Rafdigo/portable-weather-data-logger/dr2/README.md

# Design Review 2 (DR2) - Fabrication Package

Materials for the second design review (week 14): everything needed to manufacture both boards.

Suggested contents of this folder:

- Gerber and drill files, pick-and-place data
- Final BOM and assembly drawings
- Layout screenshots and design rule check (DRC) report
- Review feedback and the resulting changes
