Rafdigo/portable-weather-data-logger/dr1/README.md

# Design Review 1 (DR1) - Schematics

Materials for the first design review (week 8): complete schematics of both boards.

Suggested contents of this folder:

- Schematic PDFs of Board A and Board B
- Block diagram and power budget
- Component selection notes (sensors, MCU, radio, power chain)
- Review feedback and the resulting changes
