Rafdigo/portable-weather-data-logger/docs/README.md

# Documentation

Design notes, schematic PDFs, datasheet references and design review documents.
