Rafdigo/portable-weather-data-logger/B_board/README.md

# Board B - Sensor Node

Altium project for Board B: STM32G474RET6, environmental sensors, adaptive aspiration fan, SX1262 868 MHz radio.

Put the Altium project files (.PrjPcb, .SchDoc, .PcbDoc, libraries) in this folder.
