Rafdigo/portable-weather-data-logger/A_board/README.md

# Board A - Control Node

Altium project for Board A: STM32F105R8T6TR, SD card storage, USB export, touchscreen LCD, SX1262 868 MHz radio.

Put the Altium project files (.PrjPcb, .SchDoc, .PcbDoc, libraries) in this folder.
