Rafdigo/portable-weather-data-logger/bom/README.md

# Bill of Materials

BOM exports (CSV/XLSX) and supplier notes (LCSC / JLCPCB assembly).
