Rafdigo/portable-weather-data-logger/docs/B board PDF.pdf

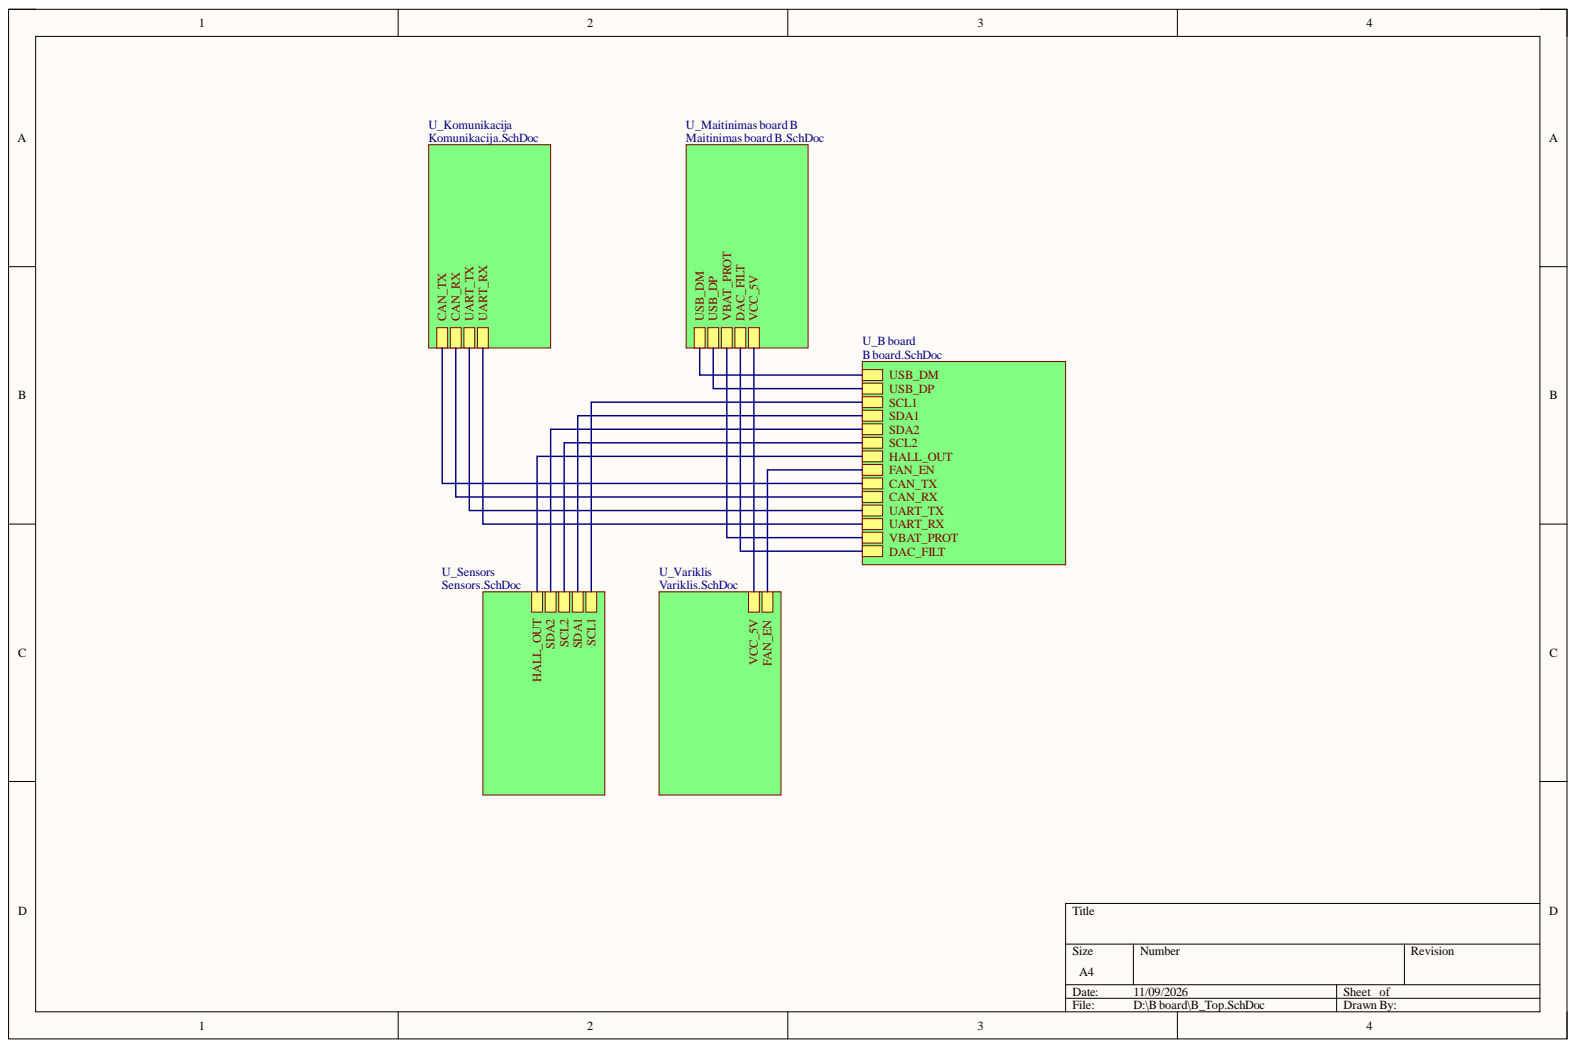
[picture p1: page 1]

Size A4 | Number | Revision

Date: 11/09/2026 | Sheet of
File: D:\Bboard\B_Top.SchDoc | Drawn By:

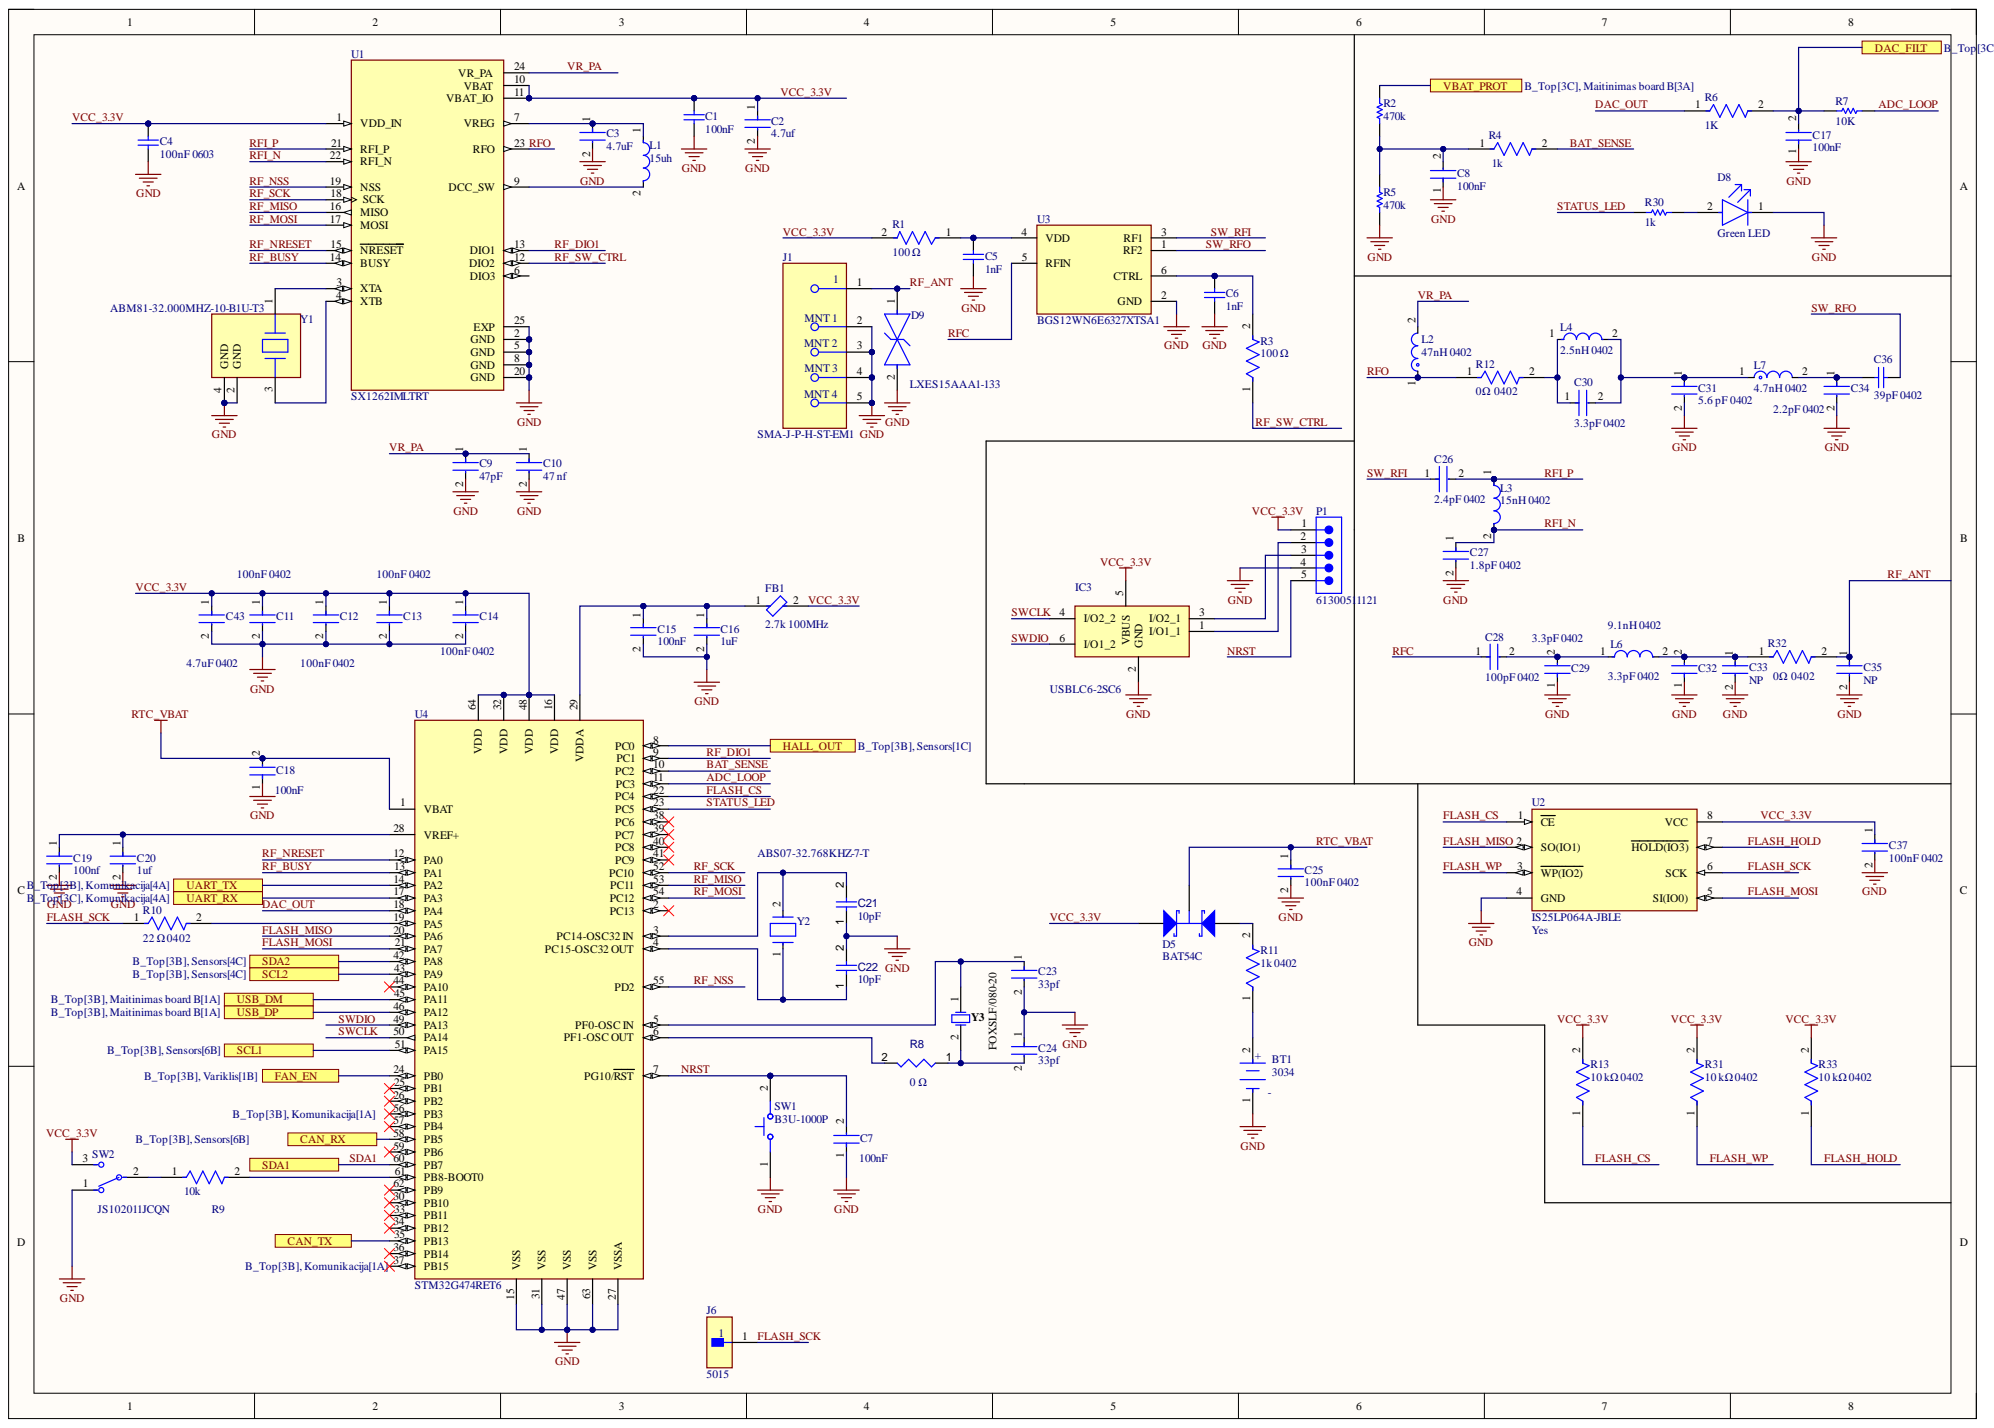
[picture p2: page 2]

CAN_TX | PB14 36

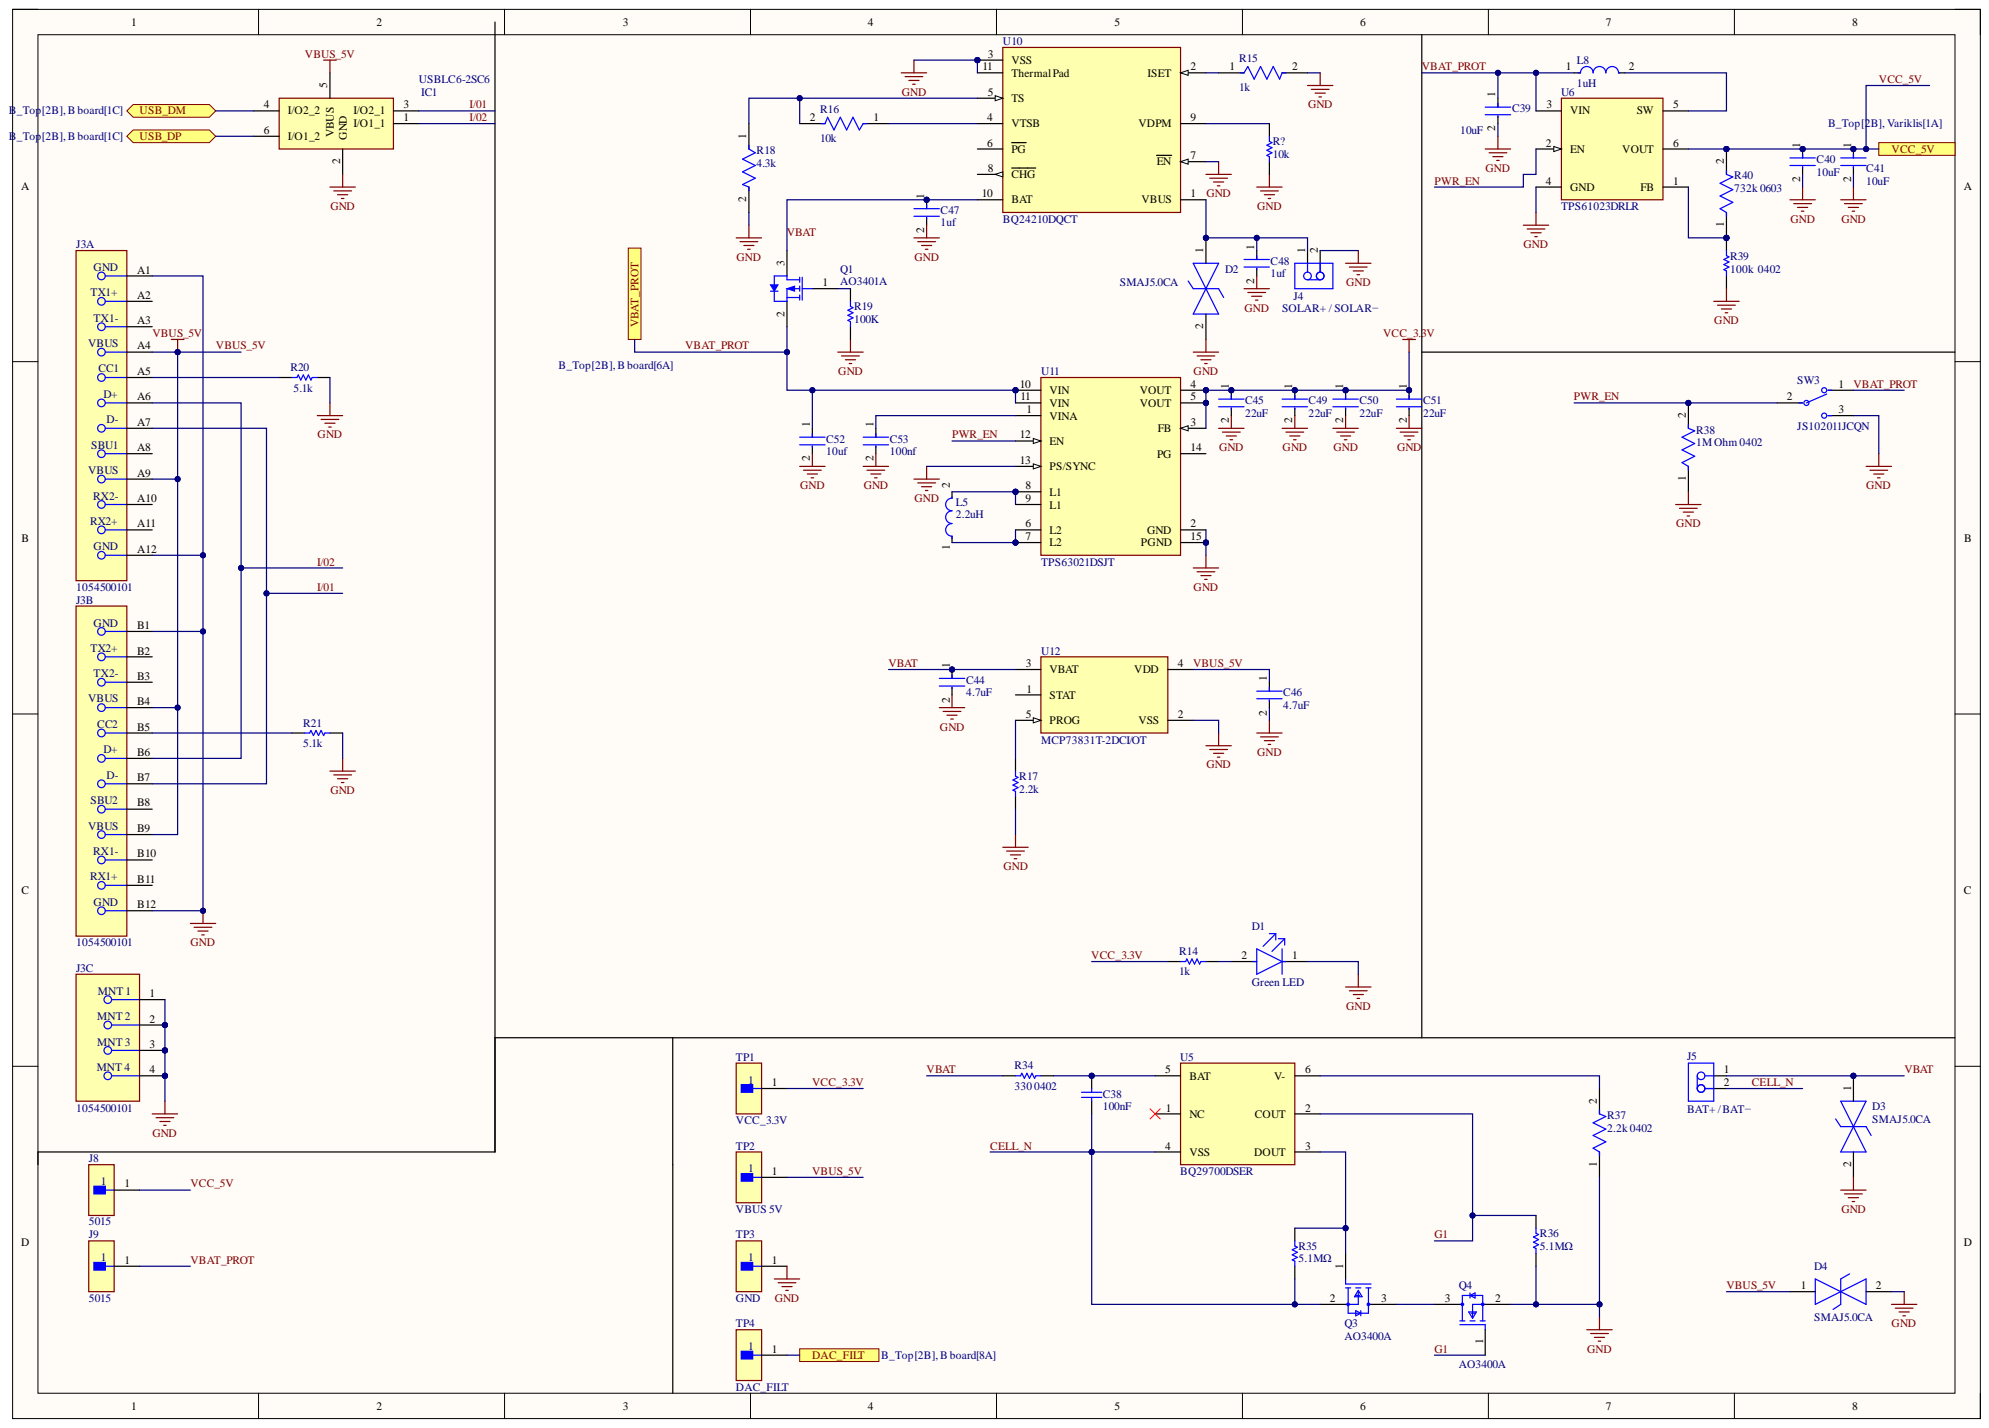
[picture p3: page 3]

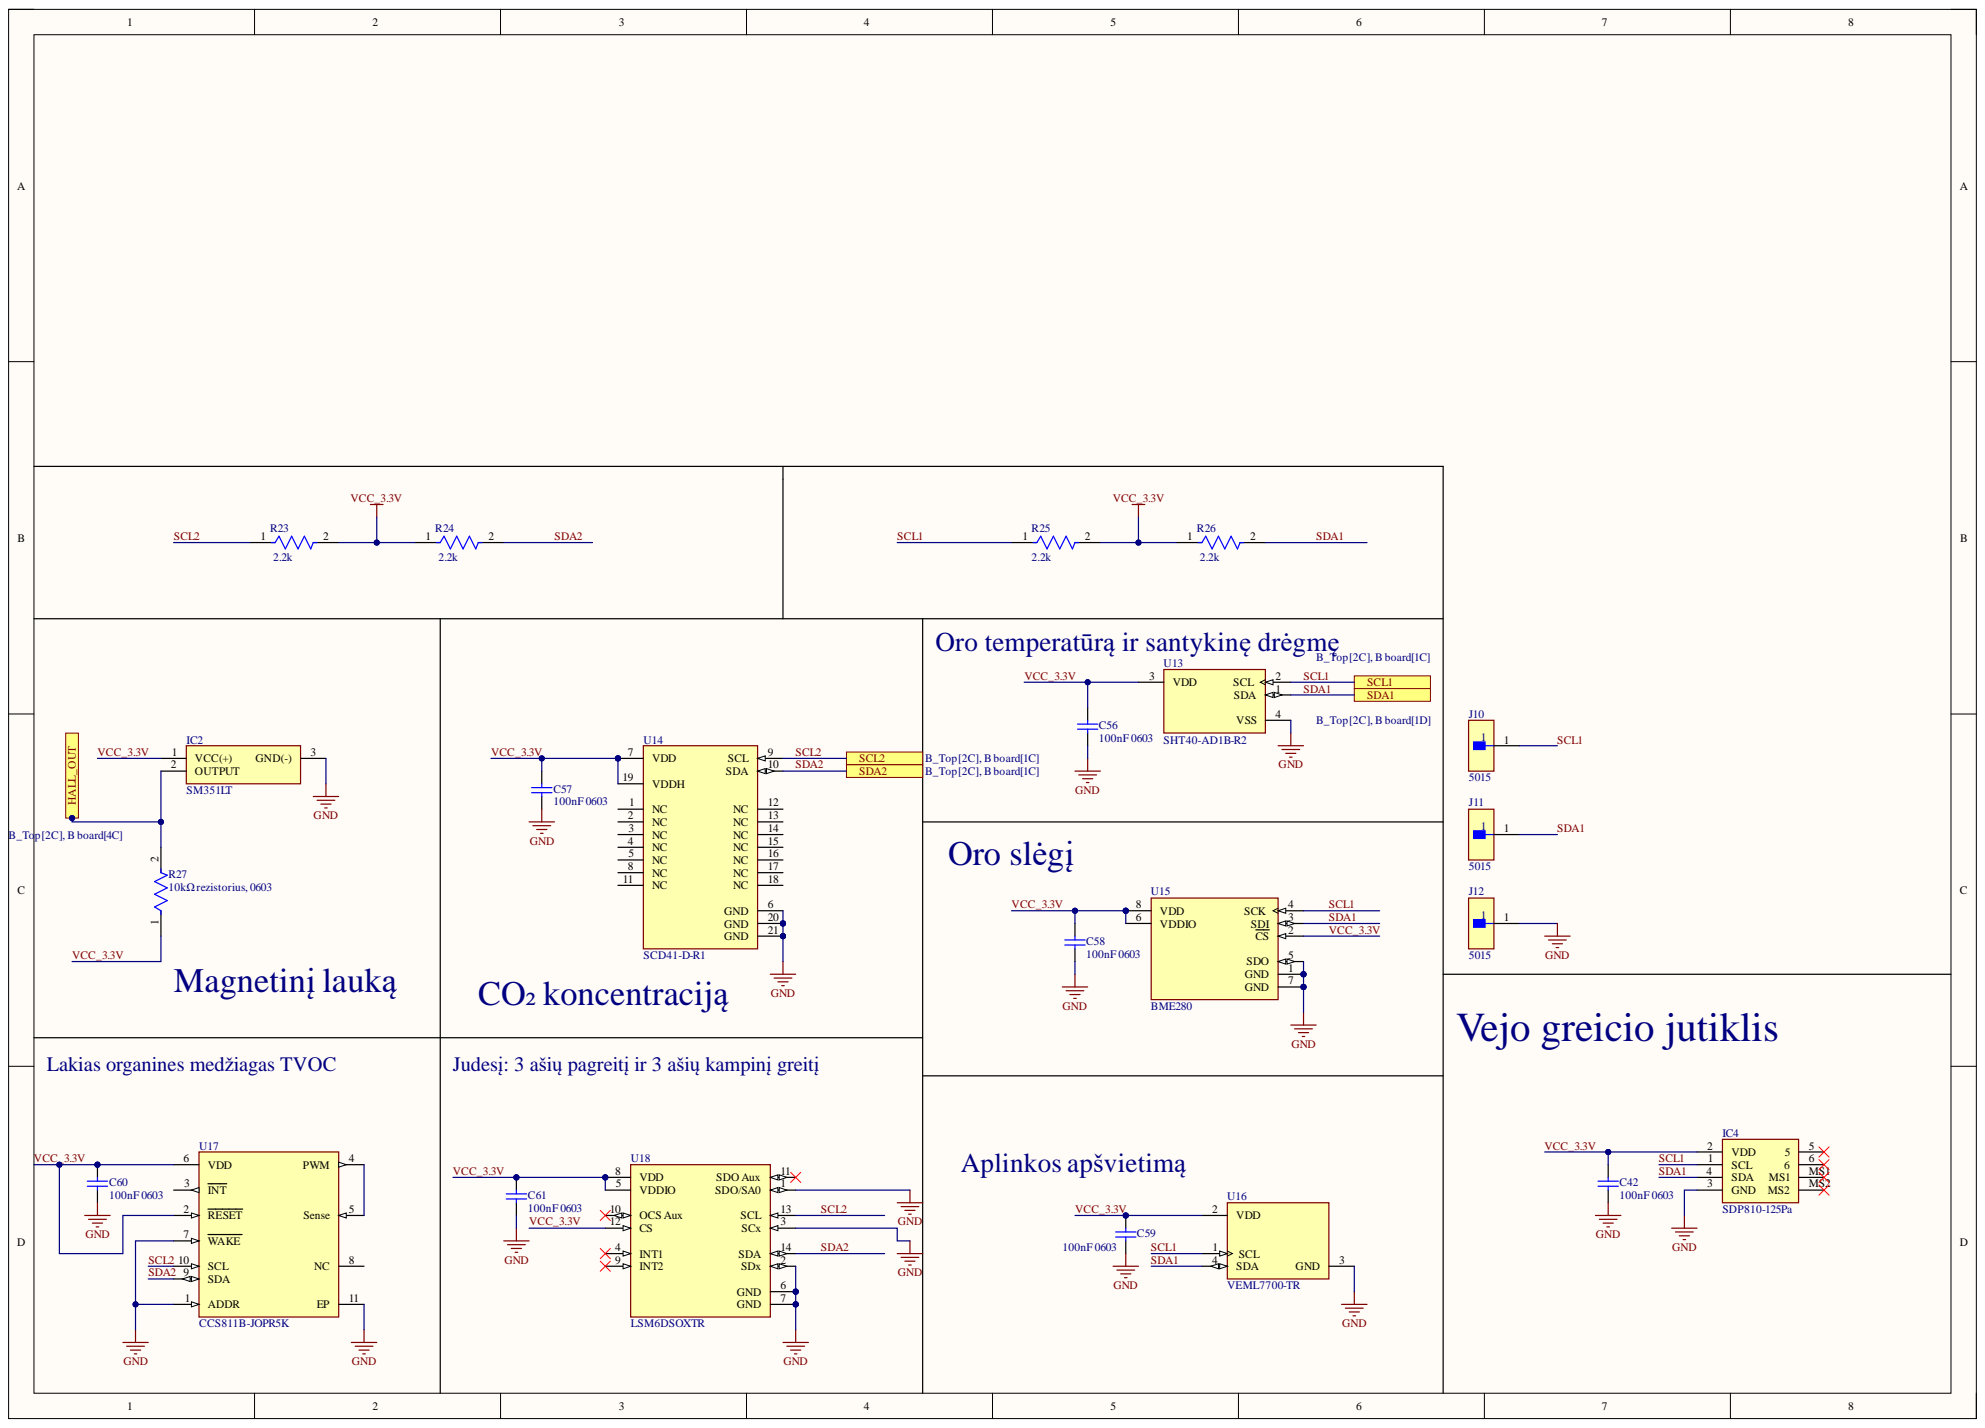
[picture p4: page 4]

Oro temperatūrą ir santykinę drėgmę

SDA1 | SCL1

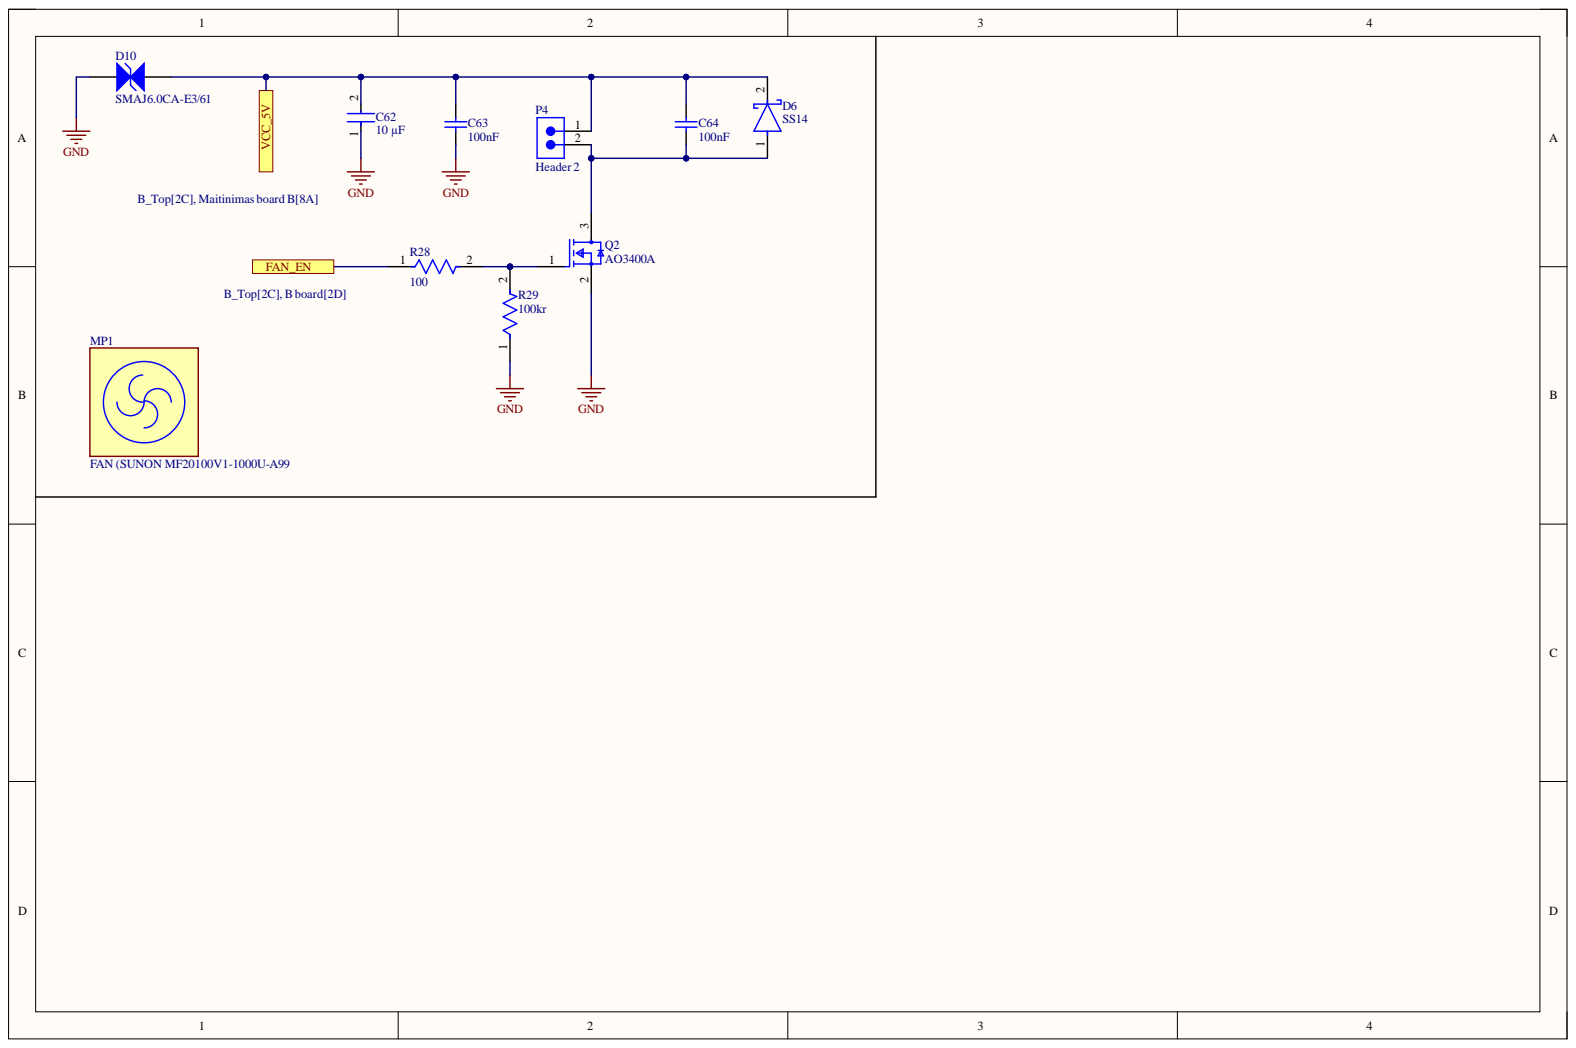
[picture p5: page 5]

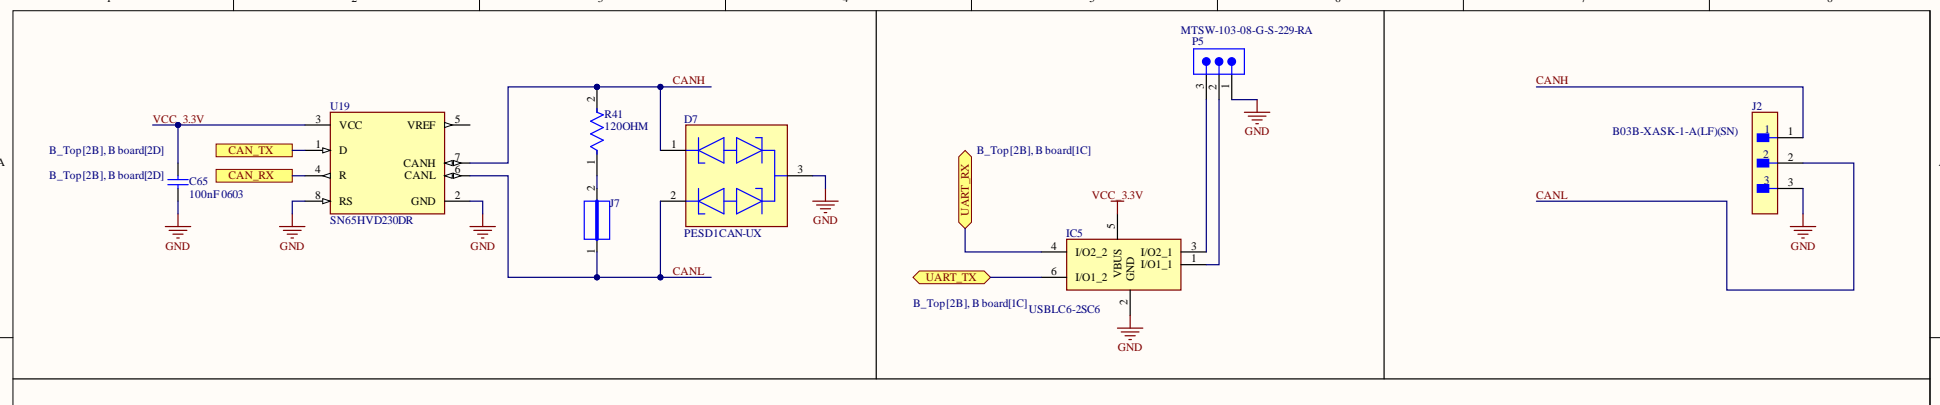
[picture p6: page 6]

100nF | | C1, C38 | CAPC1608X90X35NL1 5T15 | CMP-2006-02299-1 | 2

4.7uf | CC12064.7uFX7R 10.00%25V | C2, C3 | FP-CC1206-1_25-MFG | CMP-03422-000808-1 | 2

100nF0603 | | C4, C42, C56, C57, C58, C59, C60, C61, C65 | CAPC1608X90X35NL1 5T15 | CMP-2006-02299-1 | 9

1nF | | C5, C6 | CAPC1005X60X30ML0 5T10 | CMP-1034-01610-2 | 2

100nF | Multi-Layer Ceramic Capacitor 100nF25V X7R±10%0402Paper T/R | C7, C8, C15, C17, C18 | FP-GRT155-0_05-IPC_B | CMP-06035-021603-1 | 5

47pF | CC0402JRNPO9BN470 Multilayer Ceramic Capacitor, 47pF, 50 V, ±5%, C0G(NP0), 0402[1005Metric] | C9 | FP-CC0402-0_05-0_55-L2_0-MFG | CMP-00621-00192874-1 | 1

47nf | CAPCER0.047UF16V X7R0402 | C10 | FP-C0402-BB-MFG | CMP-03020-011259-1 | 1

100nF0402 | Multi-Layer Ceramic Capacitor 100nF25V X7R±10%0402Paper T/R | C11, C12, C13, C14 | FP-GRT155-0_05-IPC_B | CMP-06035-021603-1 | 4

1uF | Cap Ceramic 1uF35V X5R±10%SMD0402 +85°CPaper T/R | C16 | FP-CL440-IPC_C | CMP-13271-000031-1 | 1

100nf | CAPCER0.1UF50V X7R0402 | C19, C53 | FP-0402B104K500CT-IPC_C | CMP-45632-000010-1 | 2

1uf | Cap Ceramic 1uF6.3V X6S±10%SMD0402 +105°CPaper T/R | C20, C47, C48 | FP-CL858-IPC_C | CMP-13271-003231-1 | 3

Capacitor 10pF+/-5%50V0603 | Chip Capacitor, 10 pF, +/- 5%, 50V, 0603 (1608Metric) | C21, C22 | CAPC1608X90X40ML1 0T20 | CMP-001-00014-6 | 2

33pf | CAPCER33PF50V C0G/NPO0402 | C23, C24 | FP-CC0402-MFG | CMP-03422-000353-1 | 2

100nF0402 | CAPCER0.1UF50V X7R0402 | C25, C37 | FP-CC0402-MFG | CMP-03422-001010-1 | 2

2.4pF0402 | Multi-Layer Ceramic Capacitor 2.4pFC0G ±0.1pF0402Paper T/R | C26 | FP-GJM155-0_05-IPC_A | CMP-2008-03838-2 | 1

1.8pF0402 | Multi-Layer Ceramic Capacitor 1.8pFC0G ±0.05pF0402Paper T/R | C27 | FP-GJM155-0_05-IPC_B | CMP-2008-03827-2 | 1

100pF0402 | CAPCER100PF25V X7R0402 | C28 | FP-CC0402-MFG | CMP-03422-000275-1 | 1

3.3pF0402 | Multi-Layer Ceramic Capacitor 3.3pFC0G ±0.25pF0402Paper T/R | C29, C30, C32 | FP-GJM155-0_05-IPC_B | CMP-2008-03847-2 | 3

5.6pF0402 | Multi-Layer Ceramic Capacitor 5.6pFC0G ±0.1pF0402Paper T/R | C31 | FP-GJM155-0_05-MFG | CMP-2008-03865-2 | 1

NP | Multi-Layer Ceramic Capacitor 1pFC0G ±0.1pF0402Paper T/R | C33, C35 | FP-GJM155-0_05-IPC_B | CMP-2008-03808-2 | 2

2.2pF0402 | Multi-Layer Ceramic Capacitor 2.2pFC0G ±0.1pF0402Paper T/R | C34 | FP-GJM155-0_05-IPC_C | CMP-2008-03835-2 | 1

39pF0402 | | C36 | CAPC1005X55X25LL05 T10 | CMP-2008-03921-1 | 1

10uF | Chip Multilayer Ceramic Capacitors for General Purpose, 0805, 22uF, X5R, 15%, 20%, 16V | C39 | FP-GRM21B-0_2-e0_2_0_7-IPC_A | CMP-06035-026322-1 | 1

10uF | Chip Multilayer Ceramic Capacitors for General Purpose, 0805, 10uF, X5R, 15%, 10%, 25V | C40, C41 | FP-GRM21B-0_15-IPC_C | CMP-2007-03541-2 | 2

4.7uF0402 | CAPCER4.7UF10V X5R0402 | C43 | FP-CC0402-MFG | CMP-03422-000823-1 | 1

4.7uF | CL21Series 0805 4.7uF25V±10% ToleranceX5R Multilayer Ceramic Chip Capacitor | C44, C46 | FP-CL21-IPC_A | CMP-13271-002624-1 | 2

22uF | Chip Multilayer Ceramic Capacitors for General Purpose, 0805, 22uF, X5R, 15%, 20%, 10V | C45, C49, C50, C51 | FP-GRM21B-0_15-IPC_C | CMP-06035-052350-1 | 4

10uf | CAPCER10UF10V X5R0402 | C52 | FP-CL05A106MP5NUNC-MFG | CMP-13271-000002-1 | 1

10µF | Ceramic Capacitor 91pF±1%250VDCC0G 0805Paper T/R | C62 | FP-GQM219-0_15-IPC_B | CMP-06035-028339-1 | 1

100nF | | C63, C64 | CAPC1608X92X38ML1 5T08 | CMP-2006-01140-1 | 2

Green LED | LEDGREEN CLEAR CHIPSMD | D1, D8 | FP-LTST-C171GKT-MFG | CMP-22017-000007-1 | 2

SMAJ5.0CA | TVSDIODE5V9.2V SMA | D3, D4 | FP-SMAJ-MFG | CMP-2000-07091-2 | 2

BAT54C | SchottkyBarrier Diode, 30V, 2uA, -55 to 150degC, 3-Pin SOT23, RoHS, Tape and Reel | D5 | NXP-SOT23-3_V | CMP-0417-00003-1 | 1

SMAJ5.0CA | TVSDIODE5V9.2V SMA | D2 | FP-SMAJ-MFG | CMP-2000-07091-2 | 1

SS14 | DIODESCHOTTKY40V 1ASMA | D6 | FP-403AE-MFG | CMP-2000-04943-2 | 1

PESD1CAN-UX | TVSDIODE24V50V SC70-3 | D7 | FP-SOT323-MFG | CMP-14436-000006-1 | 1

LXES15AAA1-133 SMAJ6.0CA-E3/61 | TVSDIODE15V1005 Transient Voltage Suppressor, 6.40to 231V, 6VStand-off Voltage, Bi-Directional, -55to 155 degC, 2-pin DO-214AC, Pb-Free, Tape and Reel | D9 D10 | FP-LXES15-MFG VISH-DO-214AC-2_L | CMP-06195-000011-1 CMP-0548-00193-2 | 1 1

2.7k 100MHz | FERRITEBEAD2700 OHM02011LN | FB1 | FP-BLM21-0_2-t1_25-e0_3-IPC_A | CMP-06046-001048-1 | 1

SM351LT USBLC6-2SC6 SMA-J-P-H-ST-EM1 SDP810-125Pa | Integrated Circuit Integrated Circuit CONN SMAJACKSTR 50OHMEDGEMNT Integrated Circuit | IC2 IC1, IC3, IC5 J1 IC4 | SOT95P280X140-3N SOT95P280X145-6N FP-SMA-J-P-H-ST-EM1-SDP810125Pa MFG | SM351LT USBLC6-2SC6 SDP810-125Pa CMP-02754-000006-1 | 1 3 1 1

B03B-XASK-1-A(LF)(SN) | CONN HEADERVERT 3POS2.5MM | J2 | FP-B03B-XASK-1-A_LF_SN-MFG | CMP-17439-000540-1 | 1

1054500101 | CONN RCPUSB3.1 TYPEC24PSMDRA | J3 | FP-1054500101-MFG | CMP-04767-000004-1 | 1

SOLAR+/ SOLAR− | MaleHeader, Pitch 2 mm, 1x2Position, Height 6mm, Tail Length 3.4mm, -25to 85degC, RoHS, Bulk | J4 | JST-B2B-PH-K-S_V | CMP-2000-05162-1 | 1

BAT+/ BAT− | MaleHeader, Pitch 2 mm, 1x2Position, Height 6mm, Tail Length 3.4mm, -25to 85degC, RoHS, Bulk | J5 | JST-B2B-PH-K-S_V | CMP-2000-05162-1 | 1

5015 | PCTESTPOINT MINIATURE | J6, J8, J9, J10, J11, J12 | FP-5015-MFG | CMP-2000-05183-2 | 6

JUMPER 15uh | Shielded Multilayer JUMPER Inductor 15uH±20% 250mA1235mΩSMD 0805 | J7 L1 | JUMPER FP-MLZ2012-1_25-IPC_C | CMP-009-00061-2 CMP-08253-000252-1 | 1 1

47nH0402 | Multilayer type Inductor for Automotive47nH±2% 1.6Ω190mA0402 | L2 | FP-LQG15WH_02-IPC_C | CMP-06042-012463-1 | 1

15nH0402 | WireWound RF Inductor 15nH±2% 460mA0.16Ω0402 (1005) | L3 | FP-LQW15AN_00-W0_6-0_1-MFG | CMP-06042-012641-1 | 1

2.5nH0402 | WireWound RF Inductor 2.5nH ±0.1nH850mA0.05Ω 0402(1005) | L4 | FP-LQW15AN_00-W0_6-0_1-MFG | CMP-06042-007620-1 | 1

2.2uH | Shielded Multilayer Inductor 2.2uH±20% 1200mA137.5mΩ SMD0806 | L5 | FP-MLP2016M-MFG | CMP-08253-000274-1 | 1

9.1nH0402 | WireWound RF Inductor 9.1nH±2% 540mA0.14Ω0402 (1005) | L6 | FP-LQW15AN_00-W0_6-0_1-MFG | CMP-06042-009985-1 | 1

4.7nH0402 | Multilayer typeRF Inductor 4.7nH ±0.2nH0.16Ω700mA 0402 | L7 | FP-LQG15HH_02-IPC_B | CMP-06042-003214-1 | 1

1uH | Shielded Wirewound Inductor 1uH20% 3200mA0.042Ω1008 (2520) | L8 | FP-DFE252012C-IPC_B | CMP-06042-006150-1 | 1

FAN (SUNON MF20100V1-1000U-A99 | CFM-6015V-154-362 DCFan Axial omniCOOLBearing 12V4.5Vto 13.8V 30.4CFM36.2dB60X 60X15mm | MP1 | FP-CFM-6015V-154-362-MFG | CMP-12637-106233381-1 | 1

61300511121 | THTVertical Pin Header WR-PHD, Pitch 2.54mm, Single Row, 5pins | P1 | 61300511121 | CMP-1502-01068-4 | 1

Header 2 | 0.025" SQPost Header, Through-hole, Right Angle, -55 to 105degC, 2.54mm Pitch, 2-Pin, Male, RoHS | P4 | SMTC-TSW-102-22-X-S-RA | CMP-1024-00324-1 | 1

MTSW-103-08-G-S-229-RA | Modified .025" SQ Post Header, Through-hole, Right Angle, -55 to 125degC, 2.54mm Pitch, 3-Pin, Male, RoHS | P5 | SMTC-MTSW-103-08-X-S-229-RA | CMP-1024-00100-1 | 1

AO3401A | P-Channel MOSFET, 30V, 4A, -55to 150 degC, 3-Pin SOT-23-3L, RoHS, Tapeand Reel | Q1 | AO-SOT-23-3L_V | CMP-2000-05778-1 | 1

AO3400A | MOSFETN-CH30V 5.7ASOT23 | Q2, Q3, Q4 | FP-SOT23-MFG | CMP-83955-000006-1 | 3

100Ω | CRGCQ0402100R5% | R1, R3 | FP-CRGCQ0402-IPC_C | CMP-03211-004684-1 | 2

470k | | R2, R5 | RESC1005X40X25ML10 T10 | CMP-2002-03899-1 | 2

1k | CRGCQ04021KΩ1% ±100ppm/°C50V | R4 | FP-CRGCQ0402-IPC_C | CMP-03211-006314-1 | 1

1K | CRGCQ04021KΩ1% ±100ppm/°C50V | R6 | FP-CRGCQ0402-IPC_C | CMP-03211-006314-1 | 1

10K | | R7 | RESC1005X40X25ML05 T05 | CMP-2002-01181-1 | 1

0Ω | Jumper 0402(1005 Metric) | R8 | RESC0402(1005)_L | CMP-009-00062-2 | 1

22Ω0402 | 22Ω±1%0.063W0402 Thick Film Chip Resistor AEC-Q200 compliant | R10 | FP-RMCF0402-MFG | CMP-26527-006952-1 | 1

10k | 10kΩ±1%0.2W0402 Anti-SurgeChip Resistor AEC-Q200 | R9 | FP-ESR01-MFG | CMP-08839-028483-1 | 1

1k 0402 | RESThick Film, 1kΩ, 1%, 0.063W, 100ppm/°C, 0402 | R11 | FP-CRCW0402-e3-MFG | CMP-2002-08276-2 | 1

0Ω 0402 | RESThick Film, 0Ω, 0.063W, 0402 | R12, R32 | FP-CRCW0402-e3-IPC_C | CMP-2002-08122-2 | 2

10kΩ0402 | RES10kΩ±1%0.063W 0402 | R13, R31, R33 | FP-AC0402-MFG | CMP-2002-01790-3 | 3

1k | | R14, R30 | RESC1005X40X25ML10 T10 | CMP-2002-04581-1 | 2

1k | RESThin Film, 620Ω, 0.1%, 0.125W, 50ppm/°C, 0805 | R15 | FP-TFCR0805-MFG | CMP-250906-230108-1 | 1

10k | RES10kΩ5.00%0.2W 0603 | R16 | FP-AC0603-IPC_A | CMP-03412-040683-1 | 1

2.2k | | R17 | RESC1005X40X25NL10 T10 | CMP-2002-03812-1 | 1

4.3k | 4.3kΩ±1%0.063W, 1/16WChip Resistor 0402(1005Metric) Moisture Resistant Thin Film | R18 | FP-RN73R1E-MFG | CMP-04015-046329-1 | 1

100K | 100K0.75W1%1812 (4532Metric) SMD | R19 | RESC1812(4532)_L | CMP-1016-00715-1 | 1

5.1k | | R21 | RESC1005X40X25ML10 T10 | CMP-2002-04046-1 | 1

5.1k | | R20 | RESC1005X40X25ML10 T10 | CMP-2002-04046-1 | 1

2.2k | 2.2kΩ±1%0.1W0603 Thick Film Chip Resistor AEC-Q200 compliant | R23, R24, R26 | FP-RMCF0603-IPC_C | CMP-26527-001021-1 | 3

2.2k | 2.2kΩ±1%0.1W0603 Thick Film Chip Resistor AEC-Q200 compliant | R25 | FP-RMCF0603-IPC_C | CMP-26527-001021-1 | 1

10kΩrezistorius, 0603 | RES10KΩ0.50%0.1W 0603 | R27 | FP-AC0603-MFG | CMP-03412-024106-2 | 1

100 | RESSMD100OHM1% 1/8W0603 | R28 | FP-MCT0603-MFG | CMP-02407-008087-1 | 1

100kr | RESSMD100OHM1% 1/8W0603 | R29 | FP-MCT0603-IPC_C | CMP-02407-008119-1 | 1

3300402 | | R34 | RESC1005X40X25NL10 T10 | CMP-1011-00454-2 | 1

5.1MΩ | | R35, R36 | RESC1005X40X25ML05 T05 | CMP-1011-00163-2 | 2

2.2k 0402 | 2.2kΩ±1%0.2W0402 Anti-SurgeChip Resistor AEC-Q200 | R37 | FP-ESR01-IPC_B | CMP-08839-005908-1 | 1

1MOhm 0402 | Res Thick Film 0402 1MOhm 1% 0.063W(1/16W) ±100ppm/CPad SMD AutomotiveT/R | R38 | FP-CRGCQ0402-IPC_C | CMP-03211-005885-1 | 1

100k 0402 | | R39 | RESC1005X40X25NL05 T10 | CMP-2002-07343-1 | 1

732k 0603 | RESThick Film, 732kΩ, 1%, 0.1W, 100ppm/°C, 0603 | R40 | FP-CRCW0603-e3-IPC_B | CMP-1012-00834-2 | 1

120OHM | 120Ω±5%0.05W0201 Thick Film Chip Resistor AEC-Q200 compliant | R41 | FP-RMCF0201-IPC_B | CMP-26527-005399-1 | 1

10k | | R? | RESC3225X60X45NL20 T20 | CMP-2005-01993-1 | 1

B3U-1000P | TactileSwitch, SPST-NO, 0.05A, 12V, -25 to 70degC, 2-Pin SMD, RoHS, Tapeand Reel | SW1 | OMRON-B3U-1000_V | CMP-011-00000-2 | 1

JS102011JCQN | SWITCHSLIDESPDT 300MA6V | SW2, SW3 | FP-JS102011JCQN-MFG | CMP-10038-000010-1 | 2

VCC_3.3V | PCTESTPOINT MINIATURE | TP1 | FP-5015-MFG | CMP-2000-05183-2 | 1

VBUS5V | PCTESTPOINT MINIATURE | TP2 | FP-5015-MFG | CMP-2000-05183-2 | 1

GND | PCTESTPOINT MINIATURE | TP3 | FP-5015-MFG | CMP-2000-05183-2 | 1

DAC_FILT | PCTESTPOINT MINIATURE | TP4 | FP-5015-MFG | CMP-2000-05183-2 | 1

SX1262IMLTRT | ICRFTxRxOnly General ISM<1GHz LoRaWAN 150MHz~ 960MHz24-VFQFN Exposed Pad | U1 | QFN50P400X400X100-25N | SX1262IMLTRT | 1

IS25LP064A-JBLE | ICFLASH64MBIT SPI/QUAD8SOIC | U2 | FP-SOP-8-5280X5280DE-IPC_C | CMP-19782-000002-1 | 1

BGS12WN6E6327XTSA 1 | CMOSSWITCH | U3 | FP-PG-TSNP-6-MFG | CMP-32859-000005-1 | 1

STM32G474RET6 | MAINSTREAMARM CORTEX-M4COREWI | U4 | FP-LQFP64-5W-MFG | CMP-12105-000051-1 | 1

BQ29700DSER | ICLITHIUMBATT PROTECT6-SON | U5 | FP-DSE0006A-IPC_B | CMP-04911-000043-1 | 1

TPS61023DRLR | FINISHGOODSFOR TPS61023 | U6 | FP-DRL0006A-MFG | CMP-04918-000638-1 | 1

BQ24210DQCT | ICBATTCHARGERLI-ION 10WSON | U10 | FP-DQC0010A-MFG | CMP-0321-00481-3 | 1

TPS63021DSJT | ICREGBCKBST3.3V 3.5A14VSON | U11 | FP-DSJ0014A-MFG | CMP-04918-000699-1 | 1

MCP73831T-2DCI/OT | ICCONTROLLRLI-ION 4.2VSOT23-5 | U12 | FP-C04-091-OT-IPC_B | CMP-0133-00146-2 | 1

SHT40-AD1B-R2 | SENSORHUMIDITY 100RHSMD | U13 | FP-SHT40-AD1B-R2-MFG | CMP-144040-000008-1 | 1

SCD41-D-R1 | CO2SENSOR40PPM I2CSMD | U14 | FP-SCD41-D-R1-MFG | CMP-144026-000007-1 | 1

BME280 | SENSORPRESSURE HUMIDITYTEMP | U15 | FP-BME280-MFG | CMP-2000-05073-3 | 1

VEML7700-TR | SENSOROPT545NM AMBIENT4SMD | U16 | FP-6_550-5300_02-4-MFG | CMP-02530-000005-1 | 1

CCS811B-JOPR5K | CCS811B-JOPR5K LGA10LFT&R | U17 | FP-CCS811B-JOPR5K-MFG | CMP-22823-000001-1 | 1

LSM6DSOXTR | INEMOINERTIAL MODULE: 3DACCELE | U18 | FP-LGA-14L-DM00249496-MFG | CMP-12177-000010-1 | 1

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
