Rafdigo/portable-weather-data-logger/docs/A board PDF.pdf

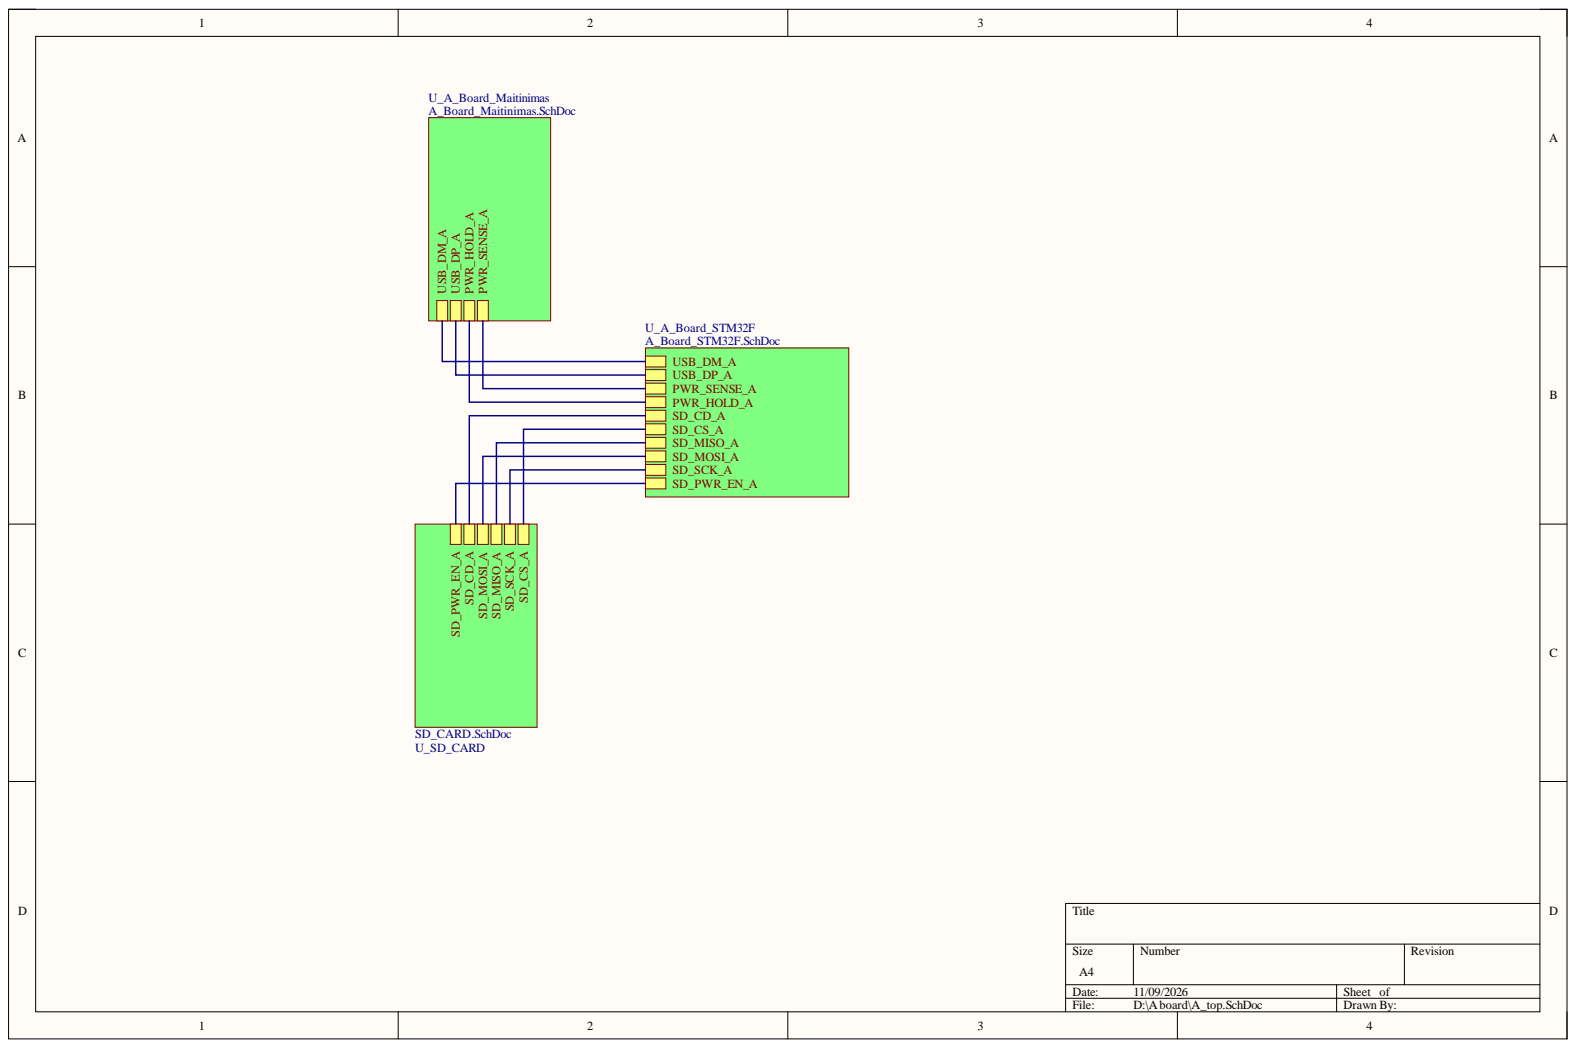
[picture p7: page 1]

Size A4 | Number | Revision

Date: 11/09/2026 | Sheet of
File: D:\Aboard\A_top.SchDoc | Drawn By:

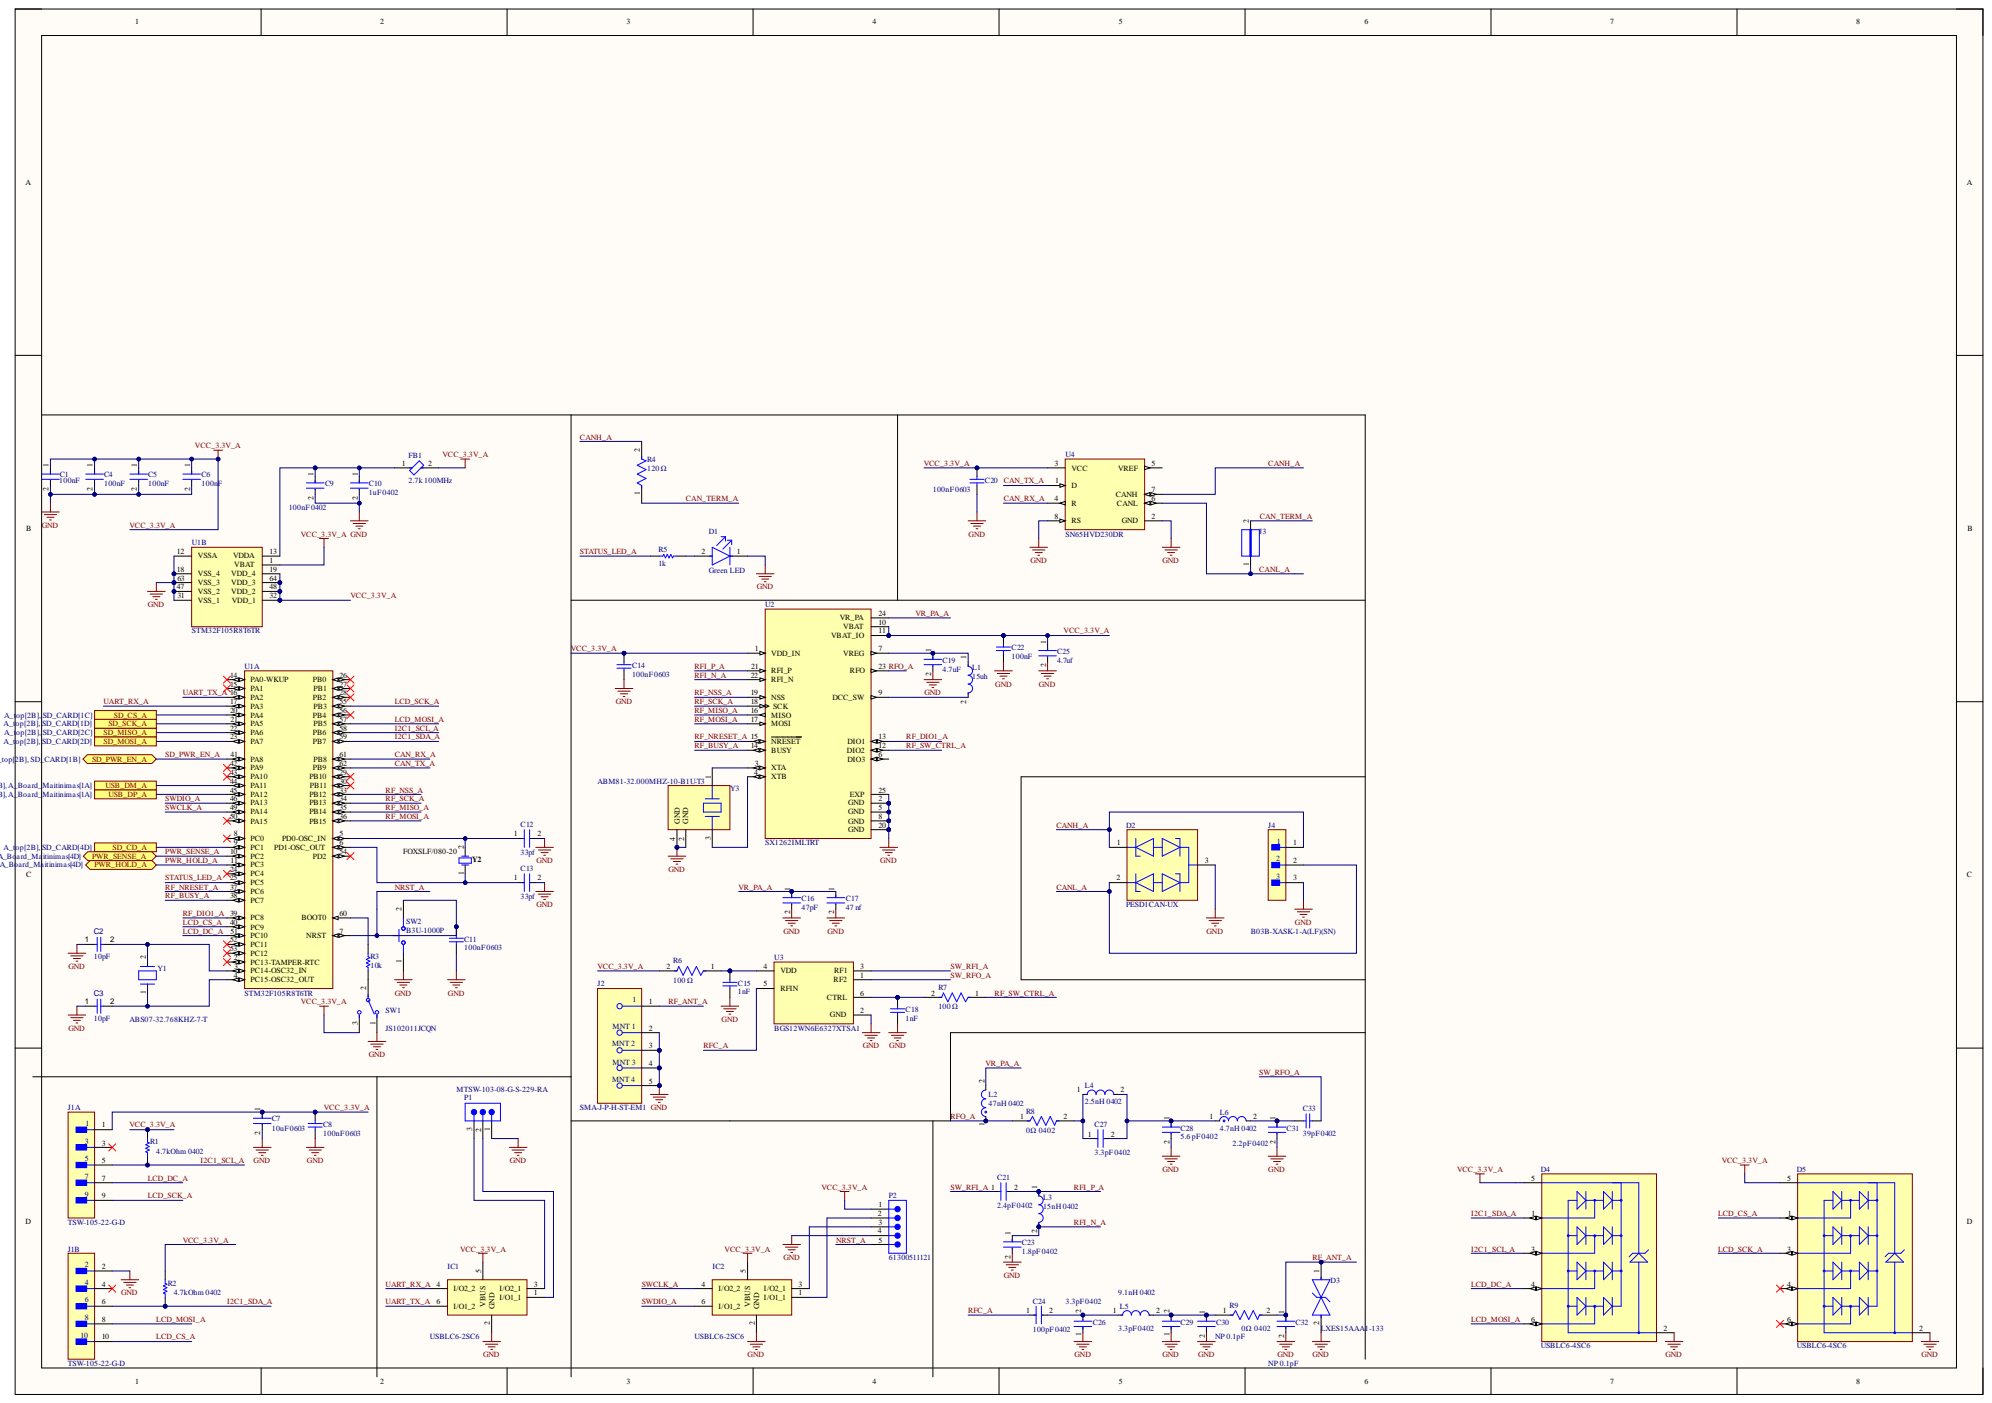
[picture p8: page 2]

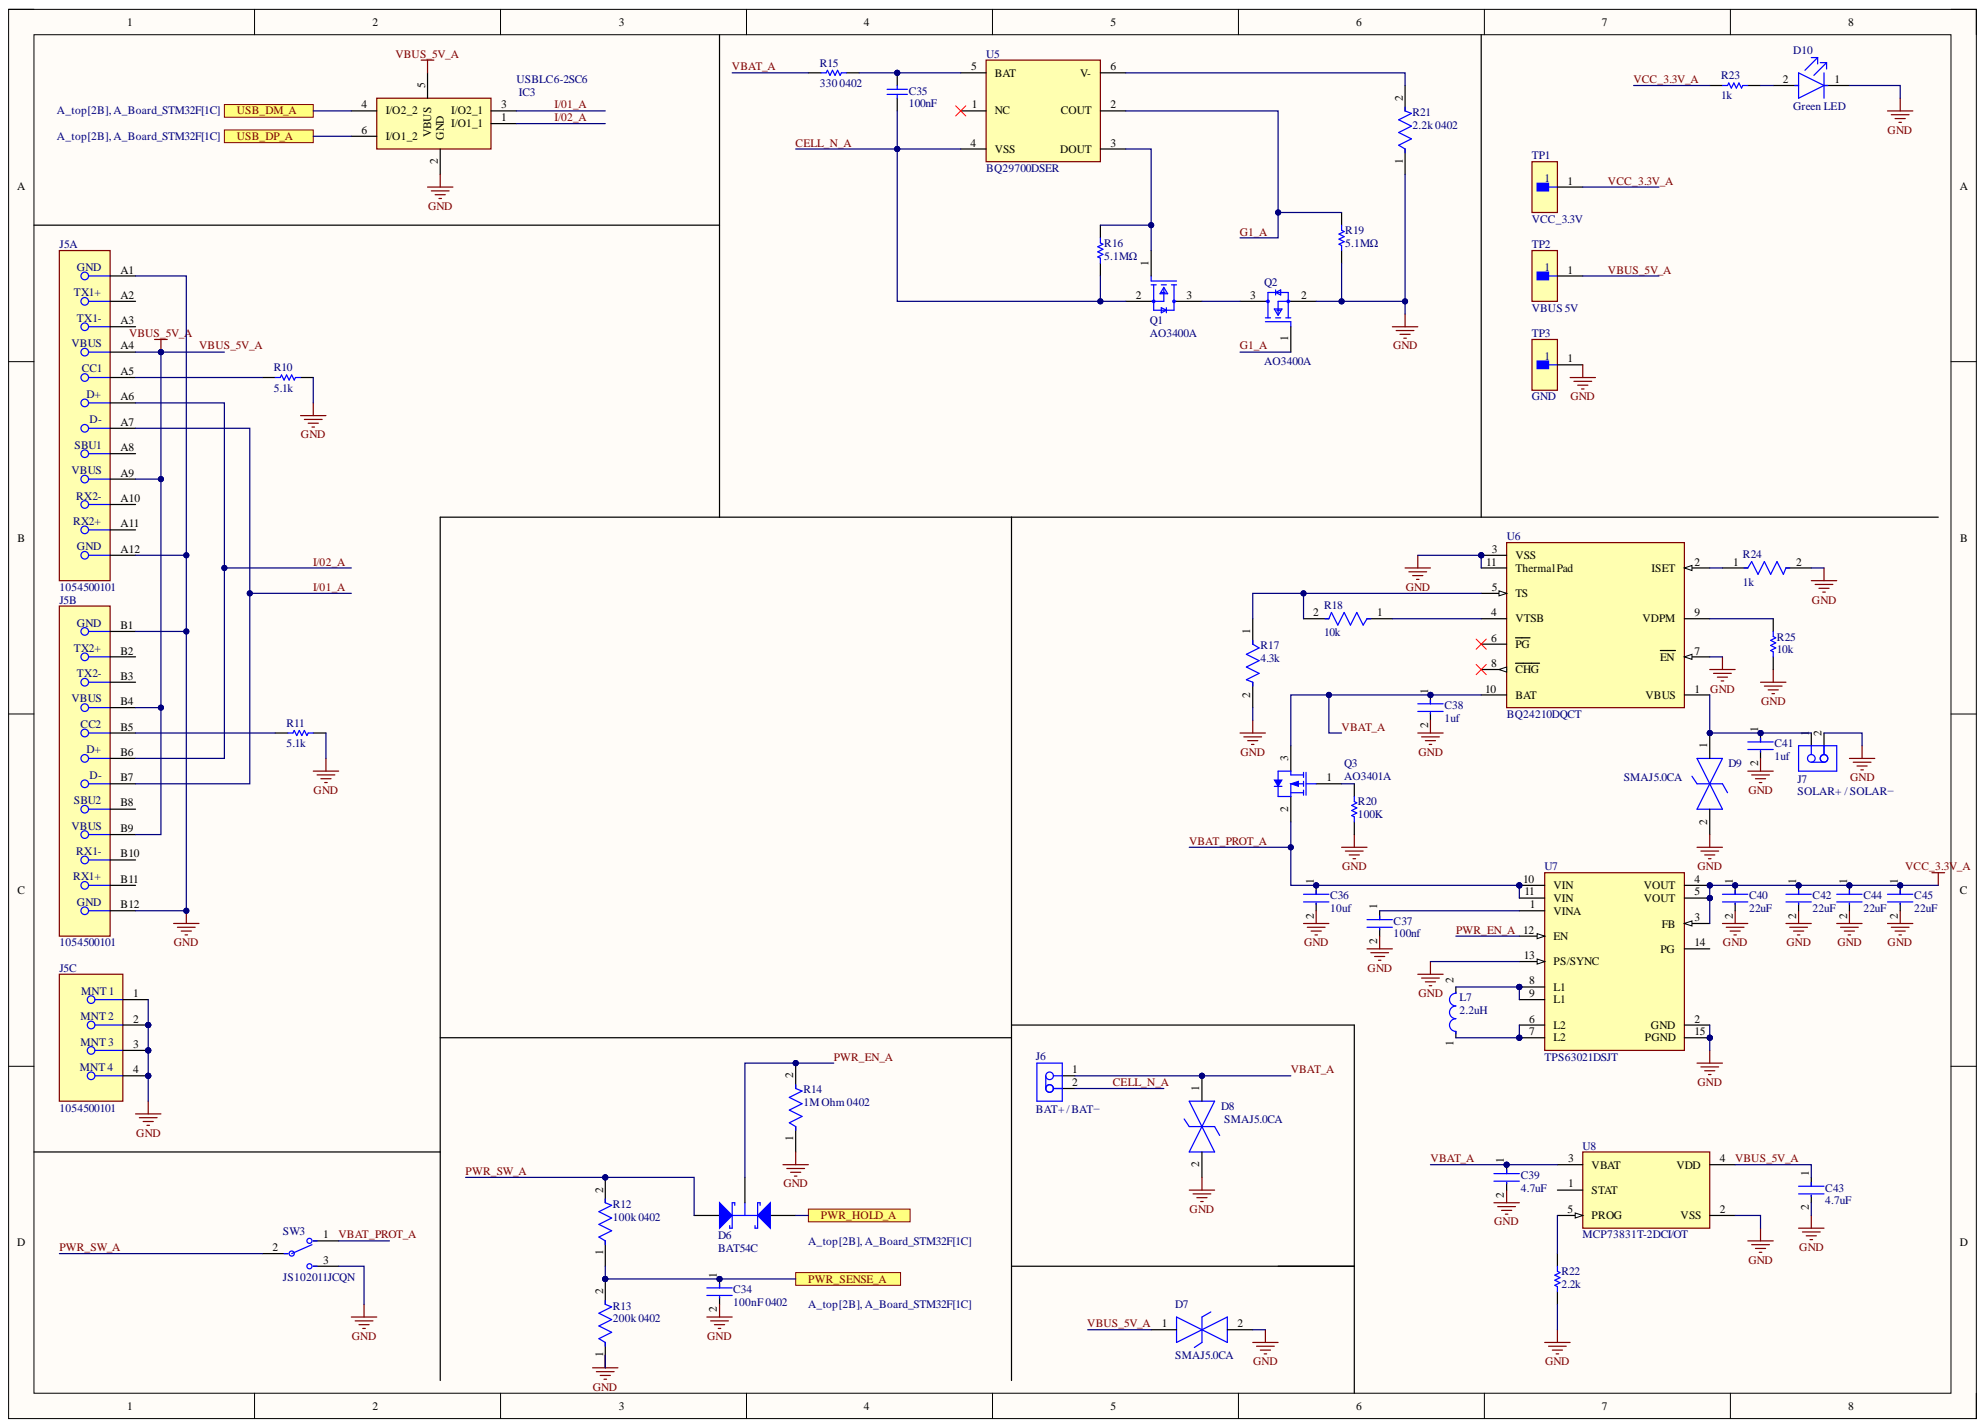
[picture p9: page 3]

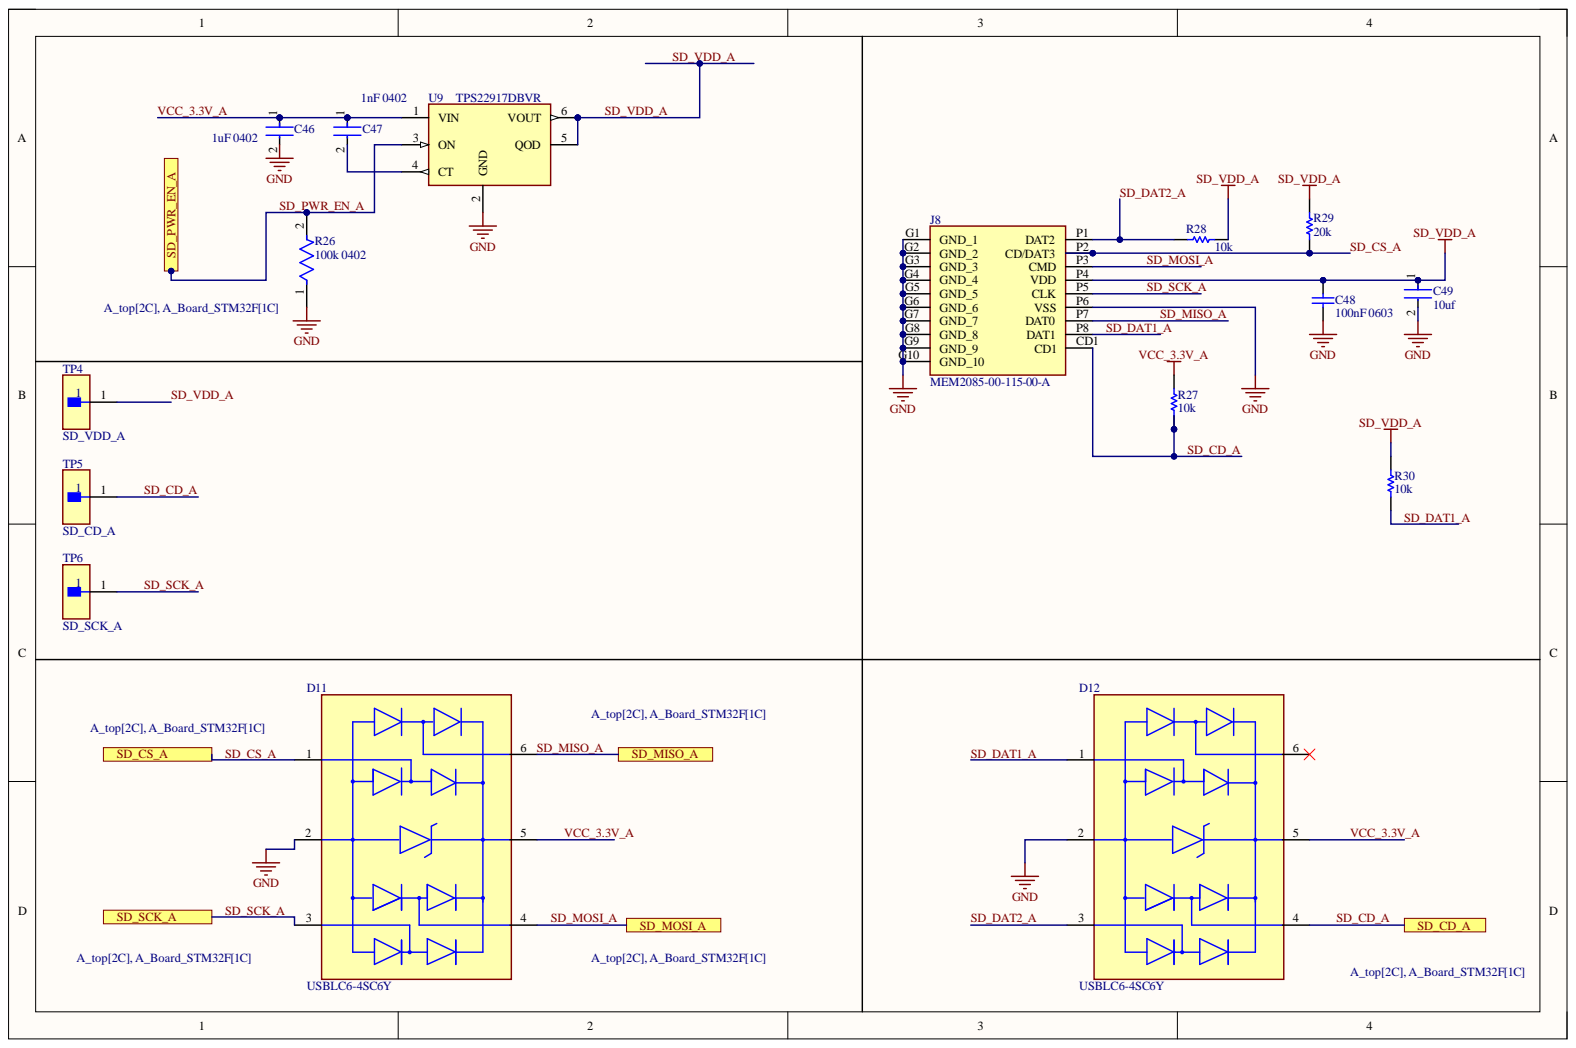
[picture p10: page 4]
