Rafdigo/portable-weather-data-logger/(list of files, drawings)

Other design files:
A_board/A_Board_Maitinimas.SchDoc
A_board/A_Board_STM32F.SchDoc
A_board/A_Board_Weather.Station.PrjPcb
A_board/A_top.SchDoc
A_board/PcbLib1.PcbLib
A_board/SD_CARD.SchDoc
B_board/B board.SchDoc
B_board/B_Top.SchDoc
B_board/Komunikacija.SchDoc
B_board/Maitinimas board B.SchDoc
B_board/Sensors.SchDoc
B_board/Variklis.SchDoc
B_board/Weather_Data.PrjPcb
